bmetk/IoTDataCollection/cad/misc/mlx90614-module-2.snapshot.2/MLX90164_Option_Code_Zoom_Optimized.jpg

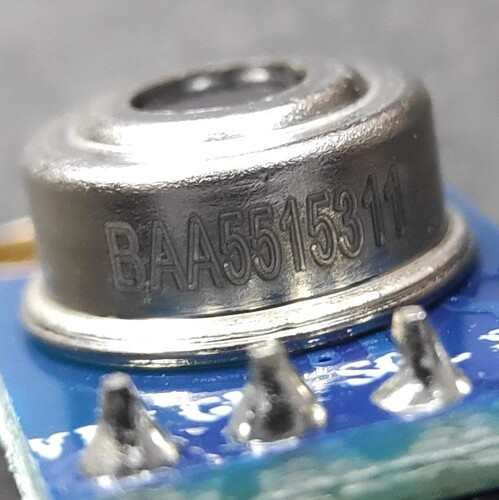
cad/misc/mlx90614-module-2.snapshot.2/MLX90164_Option_Code_Zoom_Optimized.jpg
