bmetk/IoTDataCollection/README.md

# IoTDataCollection
Thesis project: Design and development of an IoT based data collection / data analysis system
