bmetk/IoTDataCollection/cad/misc/mlx90614-module-2.snapshot.2/MLX90614XAA_Module.jpg

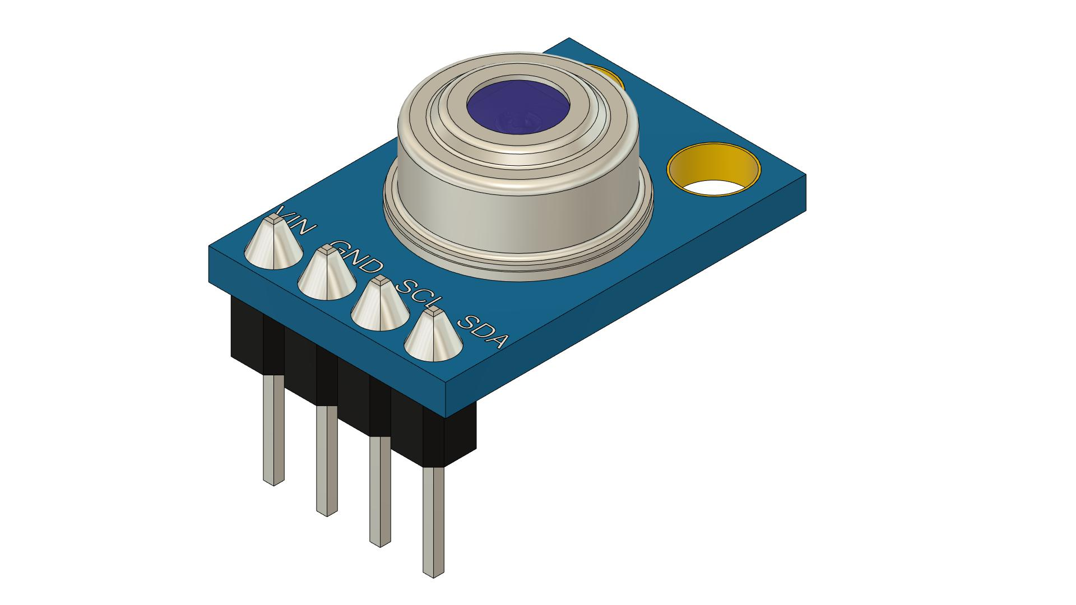
cad/misc/mlx90614-module-2.snapshot.2/MLX90614XAA_Module.jpg
