bmetk/IoTDataCollection/cad/misc/mlx90614-module-2.snapshot.2/MLX90614XAA_Module_Angle_View_Bottom.jpg

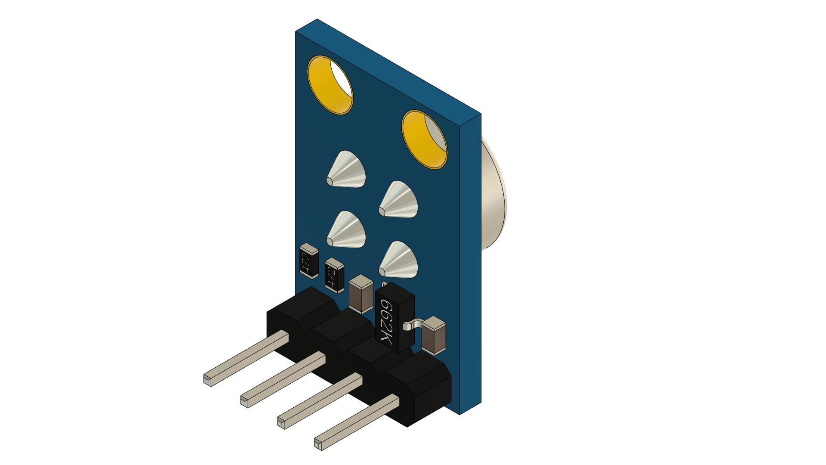
cad/misc/mlx90614-module-2.snapshot.2/MLX90614XAA_Module_Angle_View_Bottom.jpg
