bmetk/IoTDataCollection/cad/misc/mpu-9250-9dof-imu-1.snapshot.4/IMG_8919.JPG

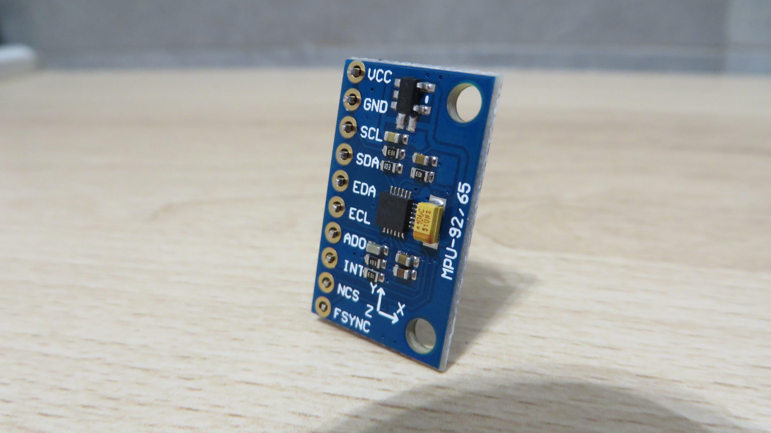
cad/misc/mpu-9250-9dof-imu-1.snapshot.4/IMG_8919.JPG
