bmetk/IoTDataCollection/cad/misc/mpu-9250-9dof-imu-1.snapshot.4/MPU-9250.png

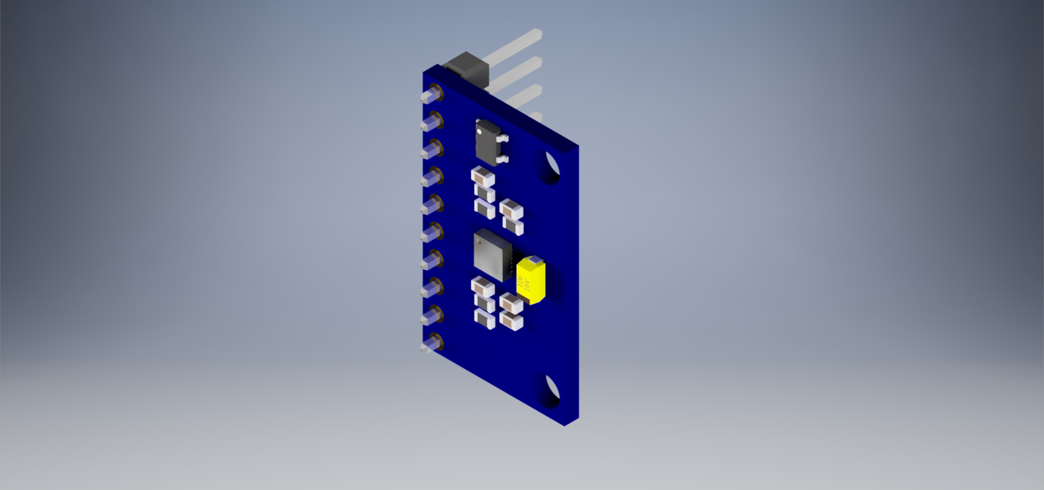
cad/misc/mpu-9250-9dof-imu-1.snapshot.4/MPU-9250.png
