bmetk/IoTDataCollection/cad/3D printing/CE3PRO_display_base.3mf

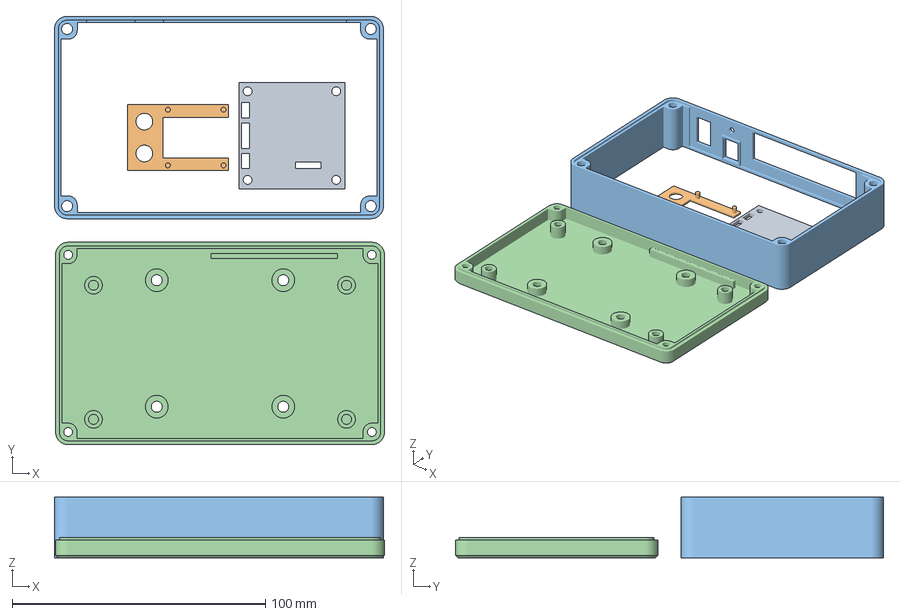
[picture p12: CAD file, 2023-10-11]
cad/3D printing/CE3PRO_display_base.3mf
130.4 x 169.3 x 24.0 mm
display_base.stl
dust_cover.stl
housing_side.stl
housing_bottom.stl
