bmetk/IoTDataCollection/cad/current sensor/current_sensor_base.stl

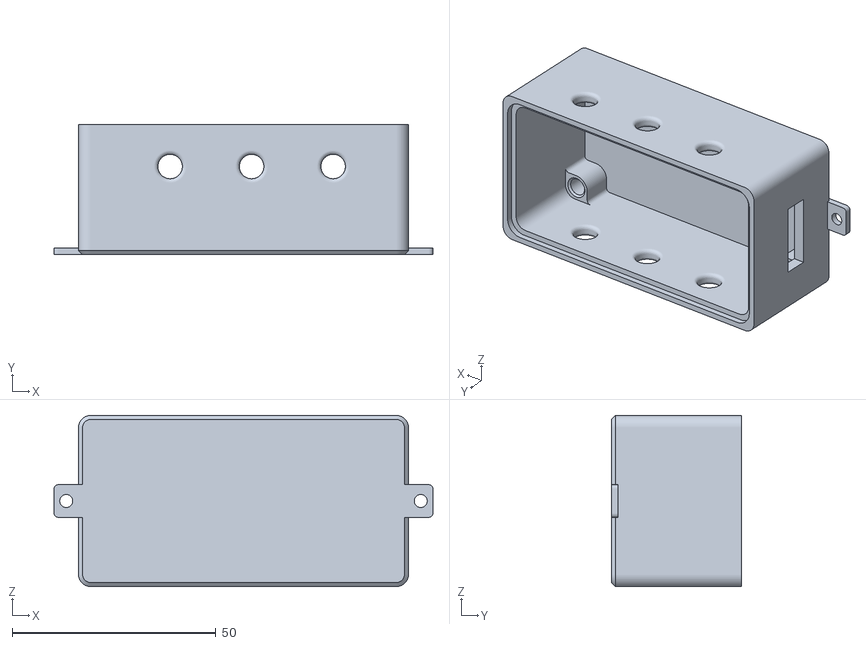
[picture p13: CAD file, 2023-11-07]
cad/current sensor/current_sensor_base.stl
93.0 x 32.0 x 42.0
