bmetk/IoTDataCollection/cad/EN3-01/disk_6_slot_wide.stl

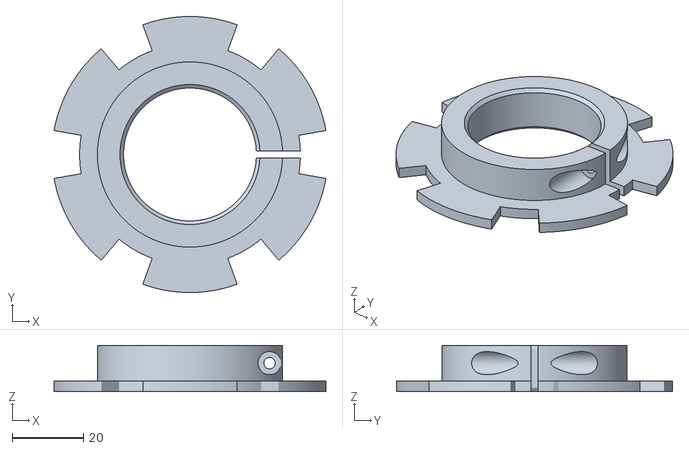
[picture p14: CAD file, 2024-02-10]
cad/EN3-01/disk_6_slot_wide.stl
76.3 x 77.5 x 13.0
