bmetk/IoTDataCollection/cad/housing/front_panel.stl

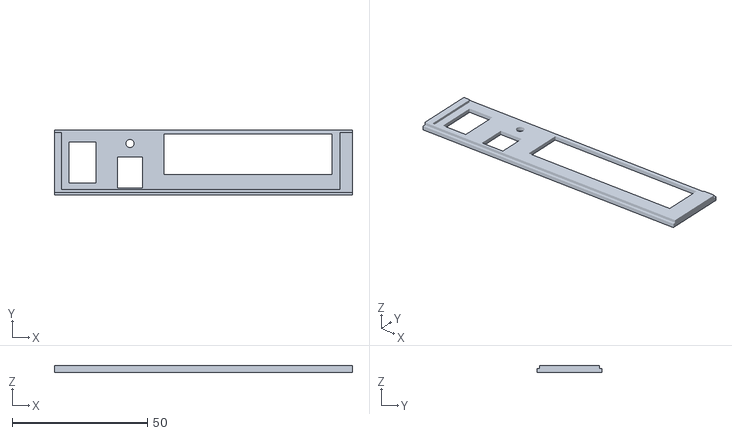
[picture p15: CAD file, 2023-10-11]
cad/housing/front_panel.stl
110.0 x 24.0 x 2.50
