bmetk/IoTDataCollection/cad/housing/v_2/housing_top_v_2_2.stl

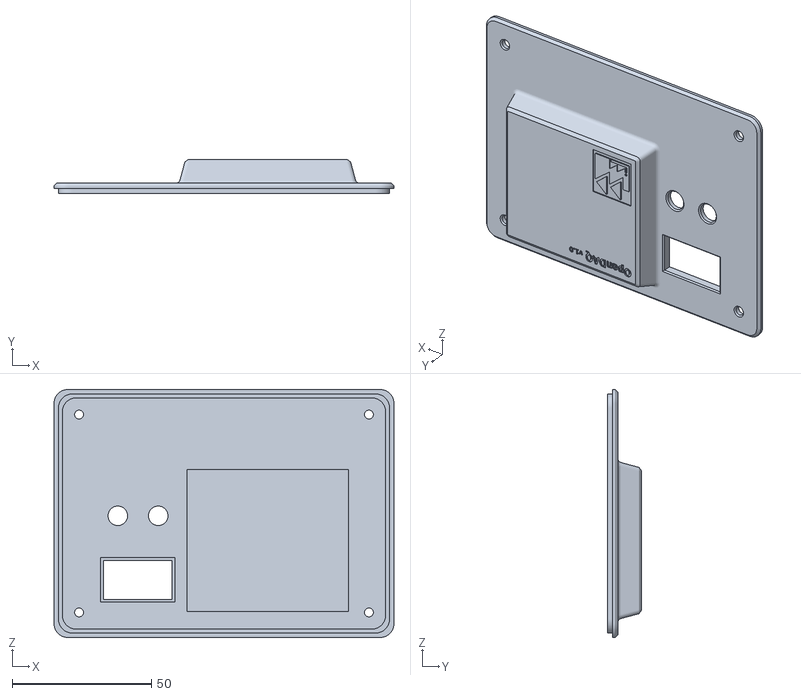
[picture p16: CAD file, 2023-11-07]
cad/housing/v_2/housing_top_v_2_2.stl
122.0 x 12.3 x 89.0
