bmetk/IoTDataCollection/cad/misc/mlx_mount_2mm.stl

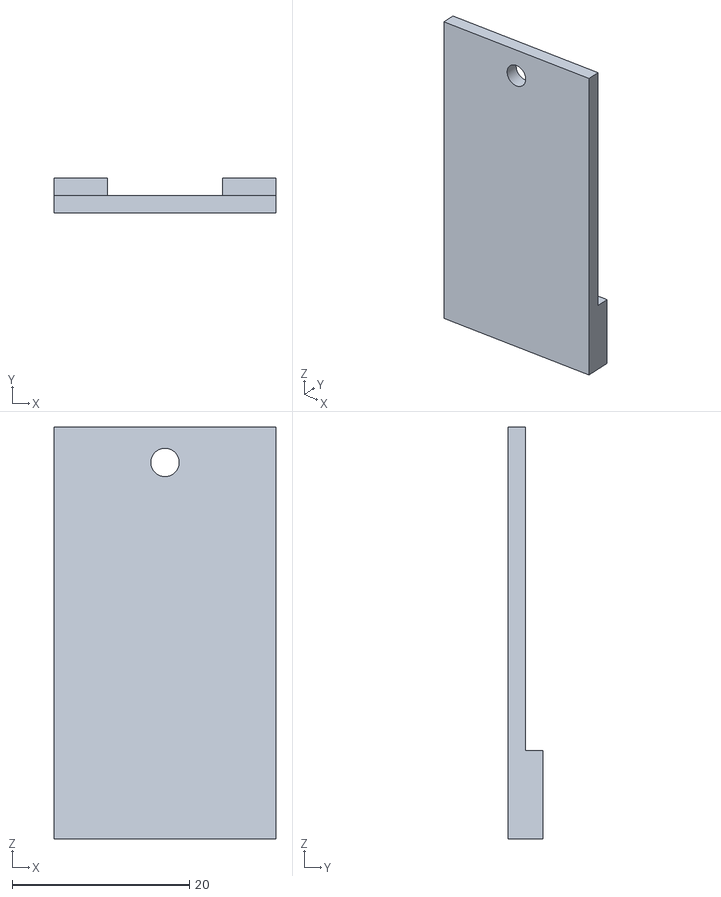
[picture p17: CAD file, 2023-11-07]
cad/misc/mlx_mount_2mm.stl
25.0 x 4.00 x 46.5
