bmetk/IoTDataCollection/cad/misc/mpu-9250-9dof-imu-1.snapshot.4/MPU-9250.stp

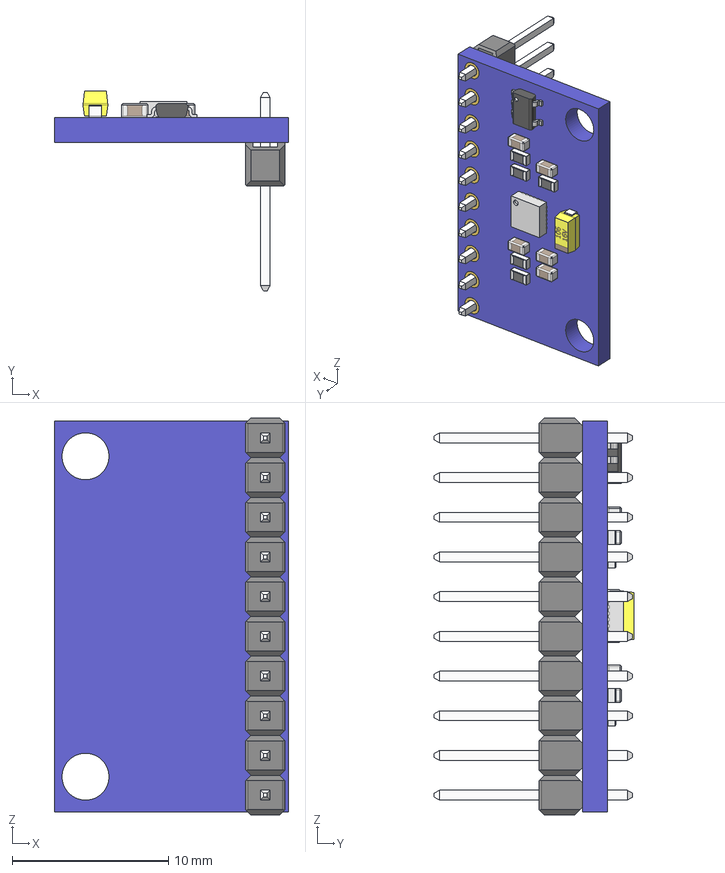
[picture p18: CAD file, 2023-11-07]
cad/misc/mpu-9250-9dof-imu-1.snapshot.4/MPU-9250.stp
15.0 x 12.8 x 25.4 mm
board
hole_plating x 20
Pin Header 1x10 TH Pitch 2.54mm
MPU-9250_1
tantalum 10uF
SOT23_5
RESC-0603 x 5
CAPC-0603-T0.9-BN x 5
