bmetk/IoTDataCollection/pcb/resources/ZMCT103C/zmct103c.stp

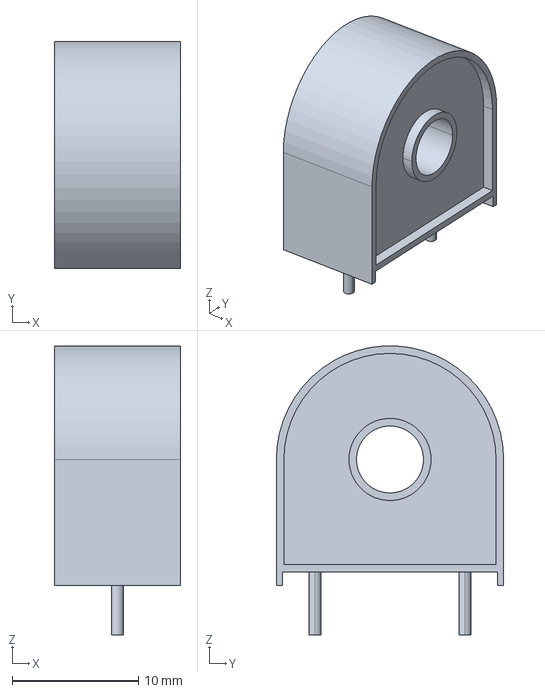
[picture p19: CAD file, 2023-11-07]
pcb/resources/ZMCT103C/zmct103c.stp
10.0 x 18.0 x 22.9 mm
