bmetk/IoTDataCollection/pcb/zmct_3phase/zmct_3phase/zmct_3phase.step

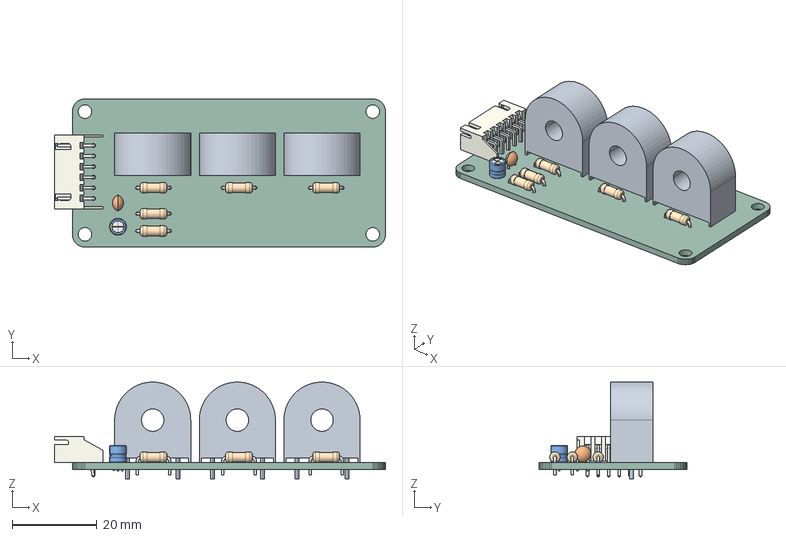
[picture p20: CAD file, 2023-11-07]
pcb/zmct_3phase/zmct_3phase/zmct_3phase.step
78.2 x 35.0 x 22.9 mm
zmct_3phase PCB
