bmetk/IoTDataCollection/cad/3D printing/dust_cover.stl

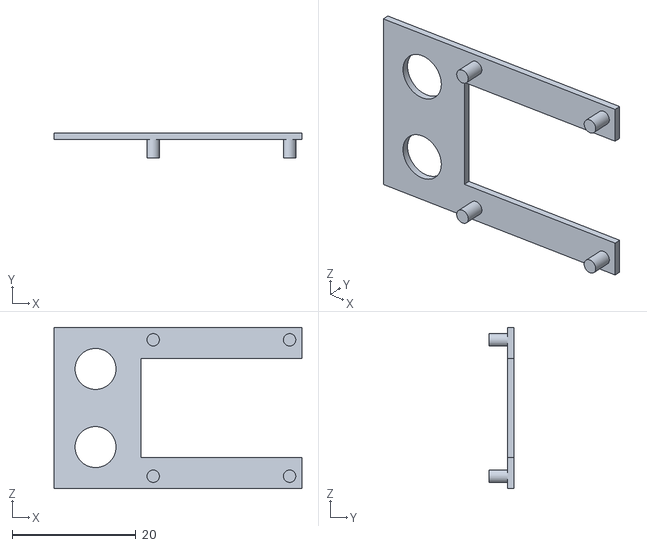
[picture p21: CAD file, 2023-10-11]
cad/3D printing/dust_cover.stl
40.0 x 4.00 x 26.0
