bmetk/IoTDataCollection/cad/current sensor/current_sensor_cover.stl

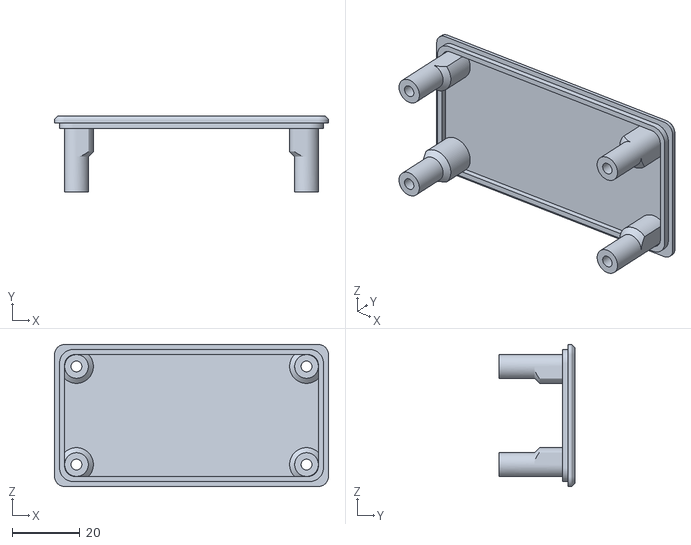
[picture p22: CAD file, 2023-11-07]
cad/current sensor/current_sensor_cover.stl
81.0 x 22.4 x 42.0
