bmetk/IoTDataCollection/cad/EN3-01/sensor_adapter.stl

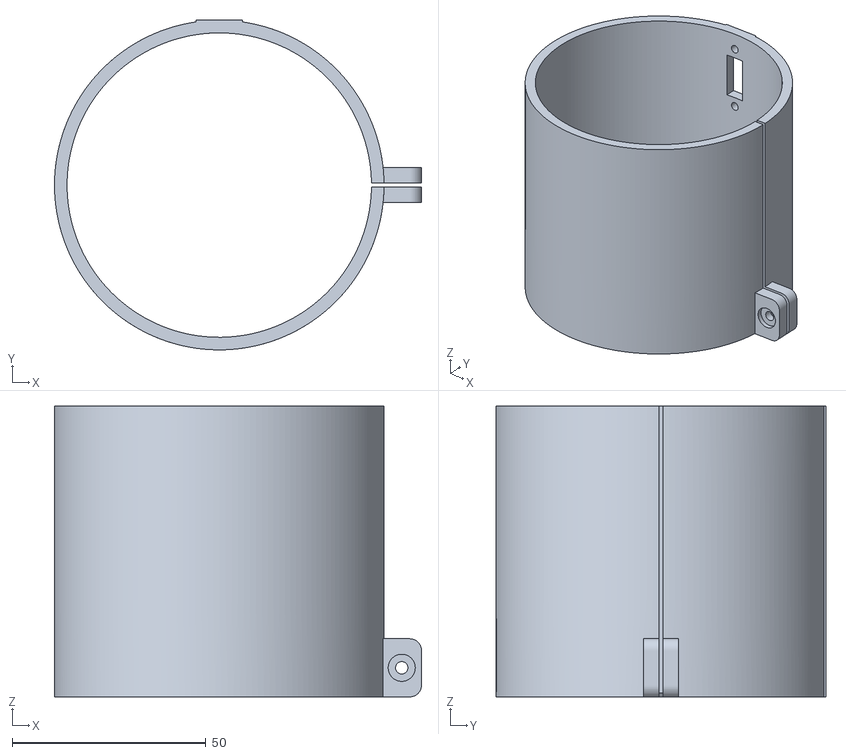
[picture p23: CAD file, 2023-11-07]
cad/EN3-01/sensor_adapter.stl
94.7 x 85.0 x 75.0
