bmetk/IoTDataCollection/cad/housing/v_2/housing_base_v_2_sw.stl

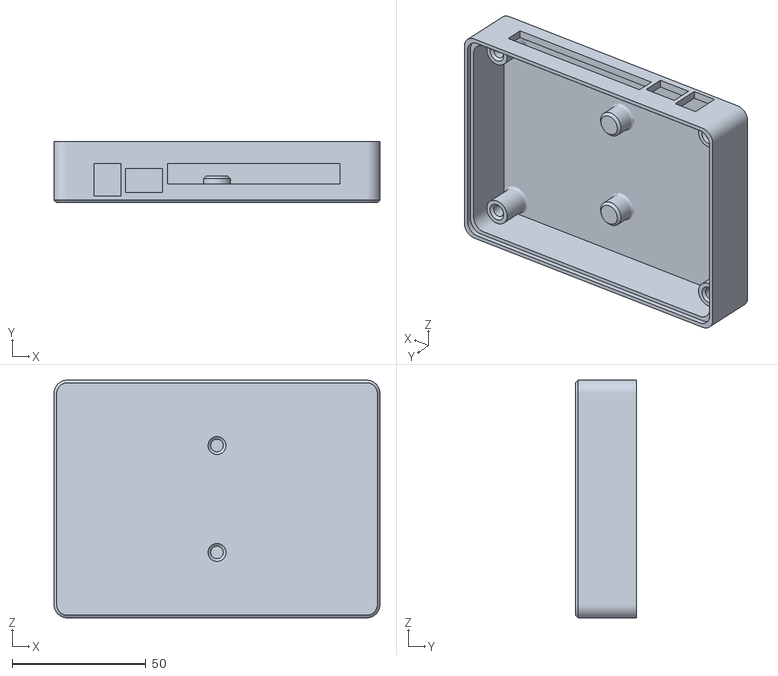
[picture p24: CAD file, 2023-10-11]
cad/housing/v_2/housing_base_v_2_sw.stl
122.0 x 23.0 x 89.0
