bmetk/IoTDataCollection/cad/misc/mlx_mount_4mm.stl

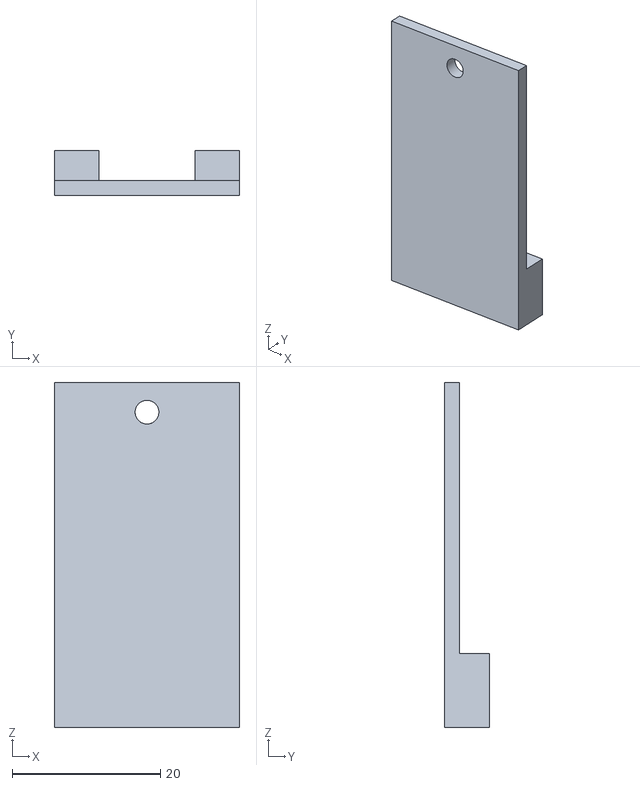
[picture p25: CAD file, 2023-11-07]
cad/misc/mlx_mount_4mm.stl
25.0 x 6.00 x 46.5
