bmetk/IoTDataCollection/cad/3D printing/display_base.stl

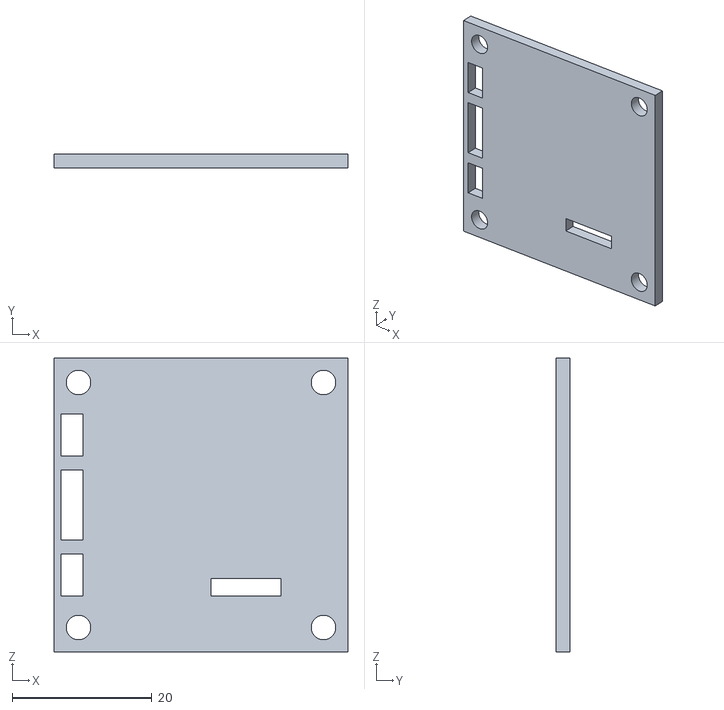
[picture p26: CAD file, 2023-10-11]
cad/3D printing/display_base.stl
42.0 x 2.00 x 42.0
