bmetk/IoTDataCollection/cad/EN3-01/disk_6_slot.stl

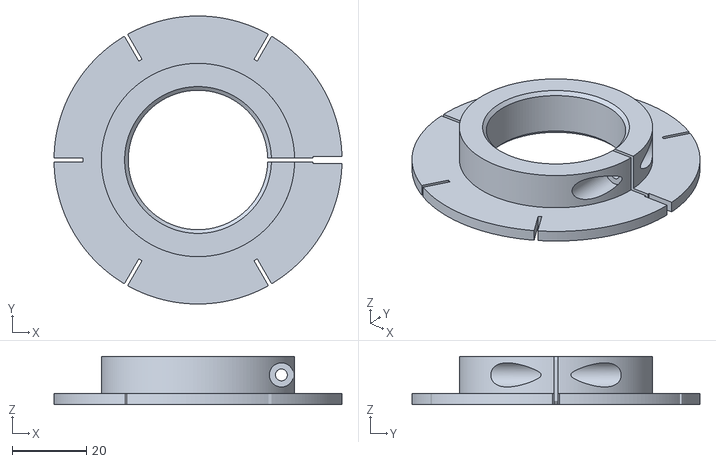
[picture p27: CAD file, 2023-11-07]
cad/EN3-01/disk_6_slot.stl
77.5 x 77.5 x 13.0
