bmetk/IoTDataCollection/cad/misc/panel_holder.stl

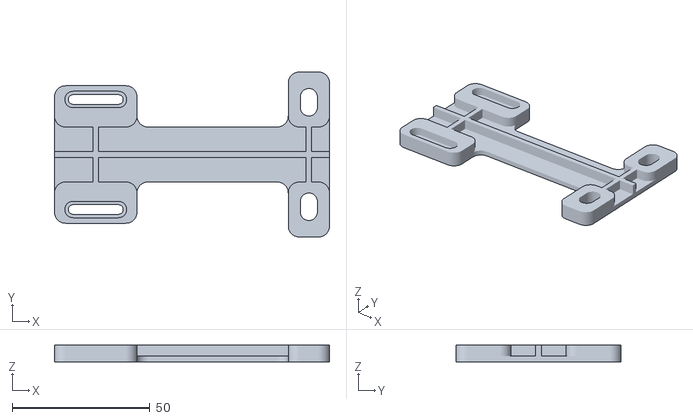
[picture p28: CAD file, 2023-11-07]
cad/misc/panel_holder.stl
100.0 x 60.0 x 6.00
