bmetk/IoTDataCollection/cad/3D printing/housing_bottom.stl

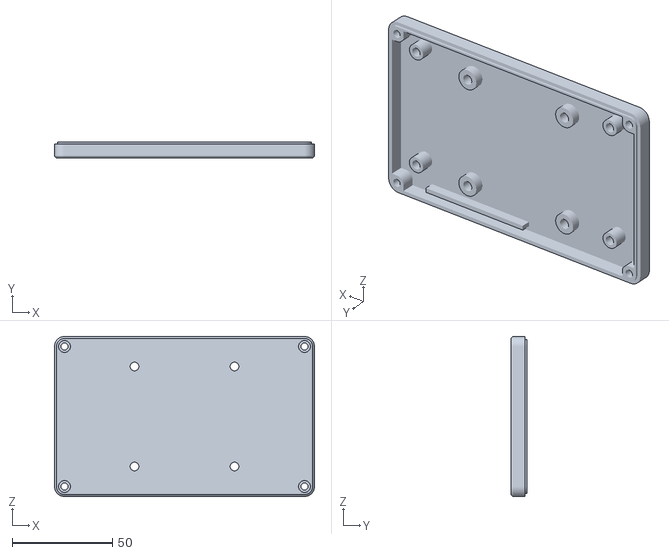
[picture p29: CAD file, 2023-10-11]
cad/3D printing/housing_bottom.stl
130.0 x 8.00 x 80.0
