bmetk/IoTDataCollection/cad/misc/mlx_mount_3mm.stl

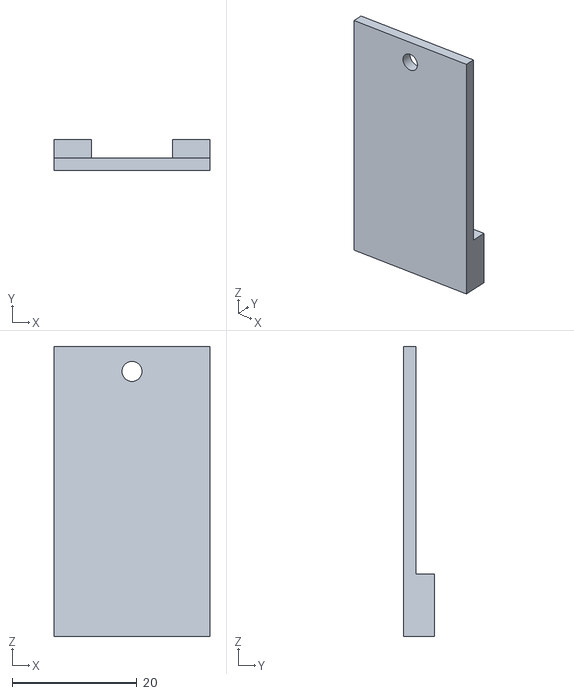
[picture p30: CAD file, 2023-11-07]
cad/misc/mlx_mount_3mm.stl
25.0 x 5.00 x 46.5
