bmetk/IoTDataCollection/cad/3D printing/housing_side.stl

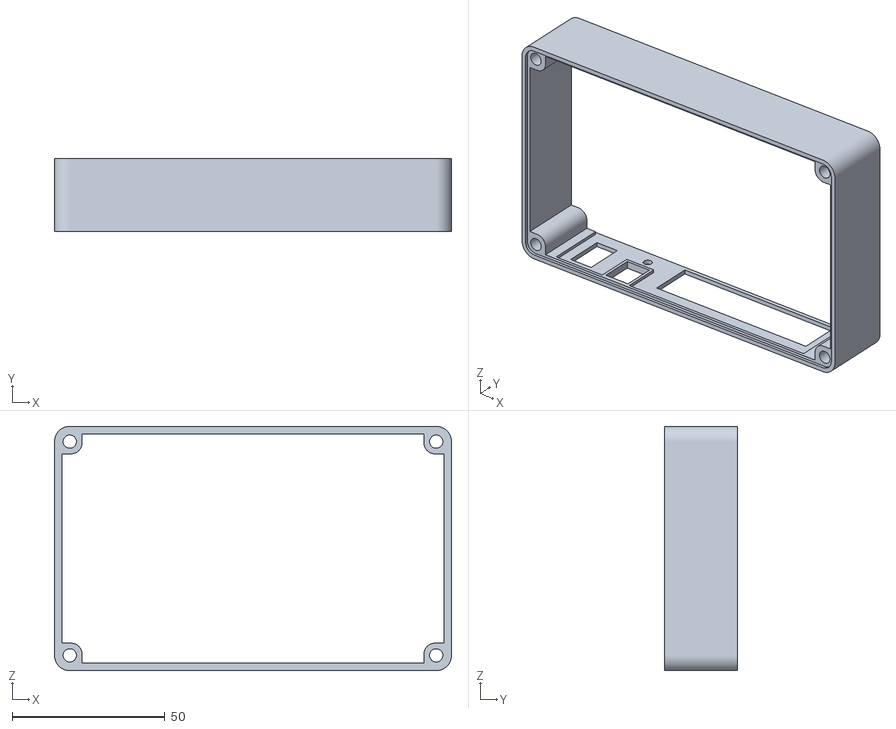
[picture p31: CAD file, 2023-10-11]
cad/3D printing/housing_side.stl
130.0 x 24.0 x 80.0
