bmetk/IoTDataCollection/cad/misc/mlx_holder.stl

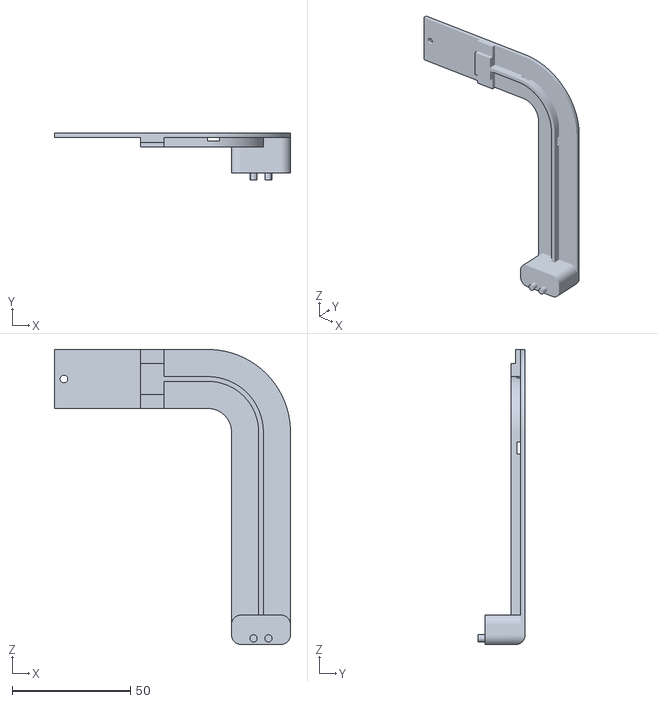
[picture p32: CAD file, 2023-11-07]
cad/misc/mlx_holder.stl
100.0 x 20.0 x 125.0
