bmetk/IoTDataCollection/cad/misc/spacer_7.5mm.stl

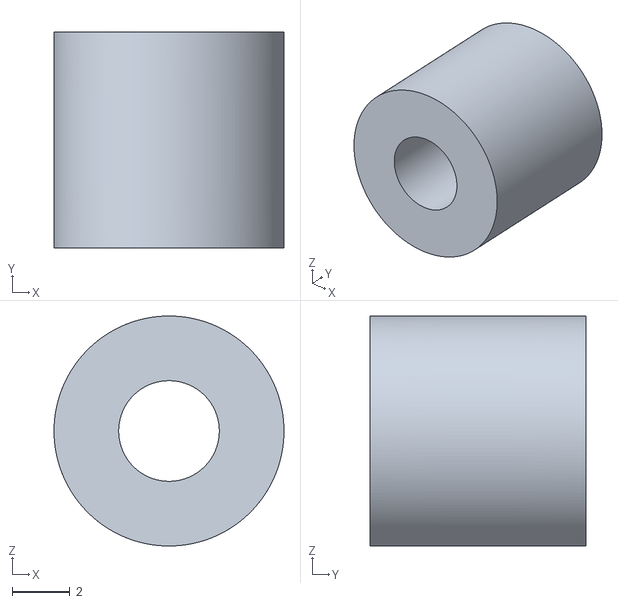
[picture p33: CAD file, 2023-10-11]
cad/misc/spacer_7.5mm.stl
8.00 x 7.50 x 8.00
