bmetk/IoTDataCollection/(list of files, cad)

Other CAD files:
pcb/resources/ZMCT103C/zmct1037.stl
cad/housing/v_2/housing_base_v_2.stl
cad/EN3-01/disk_12_slot.stl
cad/EN3-01/Assembly2.iam
cad/EN3-01/OldVersions/Assembly2.0014.iam
cad/EN3-01/OldVersions/disk_12_slot.0005.ipt
cad/EN3-01/OldVersions/disk_6_slot.0002.ipt
cad/EN3-01/OldVersions/lathe_spindle_end.0003.ipt
cad/EN3-01/OldVersions/sensor_adapter.0011.ipt
cad/EN3-01/disk_12_slot.ipt
cad/EN3-01/disk_6_slot.ipt
cad/EN3-01/disk_6_slot_wide.ipt
cad/EN3-01/lathe_spindle_end.ipt
cad/EN3-01/sensor_adapter.ipt
cad/assembly/v_1/Assembly1.iam
cad/assembly/v_1/Assembly1_for_rendering.iam
cad/assembly/v_1/OldVersions/Assembly1.0022.iam
cad/assembly/v_2/OldVersions/assembly_v_2.0014.iam
cad/assembly/v_2/OldVersions/assembly_v_2_2.0005.iam
cad/assembly/v_2/assembly_v_2.iam
cad/assembly/v_2/assembly_v_2_2.iam
cad/current sensor/OldVersions/current_sensor.0008.iam
cad/current sensor/OldVersions/current_sensor_base.0012.ipt
cad/current sensor/OldVersions/current_sensor_cover.0008.ipt
cad/current sensor/current_sensor.iam
cad/current sensor/current_sensor_base.ipt
cad/current sensor/current_sensor_cover.ipt
cad/housing/v_1/OldVersions/dust_cover.0005.ipt
cad/housing/v_1/OldVersions/front_panel.0001.ipt
cad/housing/v_1/OldVersions/housing_base.0002.ipt
cad/housing/v_1/OldVersions/housing_bottom.0014.ipt
cad/housing/v_1/OldVersions/housing_side.0018.ipt
cad/housing/v_1/OldVersions/housing_top.0015.ipt
cad/housing/v_1/OldVersions/pcb_main_populated.0001.ipt
cad/housing/v_1/dust_cover.ipt
cad/housing/v_1/front_panel.ipt
cad/housing/v_1/housing_base.ipt
cad/housing/v_1/housing_bottom.ipt
cad/housing/v_1/housing_side.ipt
cad/housing/v_1/housing_top.ipt
cad/housing/v_2/OldVersions/housing_base_v_2.0012.ipt
cad/housing/v_2/OldVersions/housing_top_v_2.0008.ipt
cad/housing/v_2/OldVersions/housing_top_v_2_2.0011.ipt
cad/housing/v_2/housing_base_v_2.ipt
cad/housing/v_2/housing_top_v_2.ipt
cad/housing/v_2/housing_top_v_2.stl
cad/housing/v_2/housing_top_v_2_2.ipt
cad/misc/OldVersions/mlx_holder.0001.ipt
cad/misc/OldVersions/mlx_mount_2mm.0001.ipt
cad/misc/OldVersions/mlx_mount_3mm.0001.ipt
cad/misc/OldVersions/mlx_mount_4mm.0003.ipt
cad/misc/OldVersions/optocoupler.0002.ipt
cad/misc/OldVersions/panel_holder.0005.ipt
cad/misc/OldVersions/rocker_switch.0003.ipt
cad/misc/button_cap.ipt
cad/misc/mlx90614-module-2.snapshot.2/MLX90614XAA_Module.f3d
cad/misc/mlx90614-module-2.snapshot.2/MLX90614XAA_Module.step
cad/misc/mlx_holder.ipt
cad/misc/mlx_mount_2mm.ipt
cad/misc/mlx_mount_3mm.ipt
cad/misc/mlx_mount_4mm.ipt
cad/misc/mpu-9250-9dof-imu-1.snapshot.4/MPU-9250.iam
cad/misc/mpu-9250-9dof-imu-1.snapshot.4/MPU-9250_Shrinkwrap.ipt
cad/misc/mpu-9250-9dof-imu-1.snapshot.4/parts/CAPC-0603-T0.9-BN.ipt
cad/misc/mpu-9250-9dof-imu-1.snapshot.4/parts/Pin Header 1x10 TH Pitch 2.54mm.ipt
cad/misc/mpu-9250-9dof-imu-1.snapshot.4/parts/QFN-24 3x3 0.4mm.ipt
cad/misc/mpu-9250-9dof-imu-1.snapshot.4/parts/RESC-0603.ipt
cad/misc/mpu-9250-9dof-imu-1.snapshot.4/parts/SOT23_5.ipt
cad/misc/mpu-9250-9dof-imu-1.snapshot.4/parts/board.ipt
cad/misc/mpu-9250-9dof-imu-1.snapshot.4/parts/hole_plating.ipt
cad/misc/mpu-9250-9dof-imu-1.snapshot.4/parts/tantalum 10uF.ipt
cad/misc/optocoupler.ipt
cad/misc/panel_holder.ipt
cad/misc/rocker_switch.ipt
cad/misc/screws/din912/din_912-m3x0_5-10-8_8.ipt
cad/misc/screws/din912/din_912-m3x0_5-10-8_8.stp
cad/misc/spacer_7.5mm.ipt
cad/pcb/OldVersions/display_base.0001.ipt
cad/pcb/OldVersions/display_buttons.0009.ipt
cad/pcb/OldVersions/pcb_main_populated.0008.ipt
cad/pcb/OldVersions/ssd1360.0001.ipt
cad/pcb/display_base.ipt
cad/pcb/display_buttons.ipt
cad/pcb/pcb_main_populated.ipt
cad/pcb/ssd1306.ipt
pcb/opendaq_carrier_1.0/BarrelJack_Wuerth_694108301002 (rev1).iam
pcb/opendaq_carrier_1.0/COMPOUND_1.ipt
pcb/opendaq_carrier_1.0/COMPOUND_2.ipt
pcb/opendaq_carrier_1.0/COMPOUND_3.ipt
pcb/opendaq_carrier_1.0/ESP32Wroom.iam
pcb/opendaq_carrier_1.0/JST_XH_B2B-XH-A_1x02_P2.50mm_Vertical.iam
pcb/opendaq_carrier_1.0/JST_XH_S3B-XH-A_1x03_P2.50mm_Horizontal.iam
pcb/opendaq_carrier_1.0/JST_XH_S4B-XH-A_1x04_P2.50mm_Horizontal.iam
pcb/opendaq_carrier_1.0/JST_XH_S5B-XH-A_1x05_P2.50mm_Horizontal.iam
pcb/opendaq_carrier_1.0/JST_XH_S6B-XH-A_1x06_P2.50mm_Horizontal.iam
pcb/opendaq_carrier_1.0/SOLID.ipt
pcb/opendaq_carrier_1.0/SOLID_1.ipt
pcb/opendaq_carrier_1.0/SOLID_2.ipt
pcb/opendaq_carrier_1.0/SOLID_3.ipt
pcb/opendaq_carrier_1.0/SOLID_4.ipt
pcb/opendaq_carrier_1.0/SOLID_5.ipt
pcb/opendaq_carrier_1.0/SSD1306_OLED_Display(128x64).iam
pcb/opendaq_carrier_1.0/Tactal Switch - THRU(12mmx12mmx8mm)-Black.iam
pcb/opendaq_carrier_1.0/kicad_module_3D_MINI560.iam
pcb/opendaq_carrier_1.0/opendaq_carrier_1.0 PCB.ipt
pcb/opendaq_carrier_1.0/opendaq_carrier_1.0.iam
pcb/resources/ZMCT103C/zmct103c.ipt
pcb/zmct_3phase/zmct_3phase/CP_Radial_D4.0mm_P2.00mm.iam
pcb/zmct_3phase/zmct_3phase/C_Disc_D3.8mm_W2.6mm_P2.50mm.iam
pcb/zmct_3phase/zmct_3phase/JST_XH_S6B-XH-A_1x06_P2.50mm_Horizontal.iam
pcb/zmct_3phase/zmct_3phase/R_Axial_DIN0207_L6.3mm_D2.5mm_P7.62mm_Horizontal.iam
pcb/zmct_3phase/zmct_3phase/SOLID.ipt
pcb/zmct_3phase/zmct_3phase/SOLID_1.ipt
pcb/zmct_3phase/zmct_3phase/SOLID_2.ipt
pcb/zmct_3phase/zmct_3phase/SOLID_3.ipt
pcb/zmct_3phase/zmct_3phase/SOLID_4.ipt
pcb/zmct_3phase/zmct_3phase/zmct103c.iam
pcb/zmct_3phase/zmct_3phase/zmct_3phase PCB.ipt
pcb/zmct_3phase/zmct_3phase/zmct_3phase.iam
