bmetk/IoTDataCollection/pcb/opendaq_carrier_1.0/opendaq_carrier_1.0.kicad_pcb

## KiCad design pcb/opendaq_carrier_1.0/opendaq_carrier_1.0.kicad_pcb (2023-10-11)

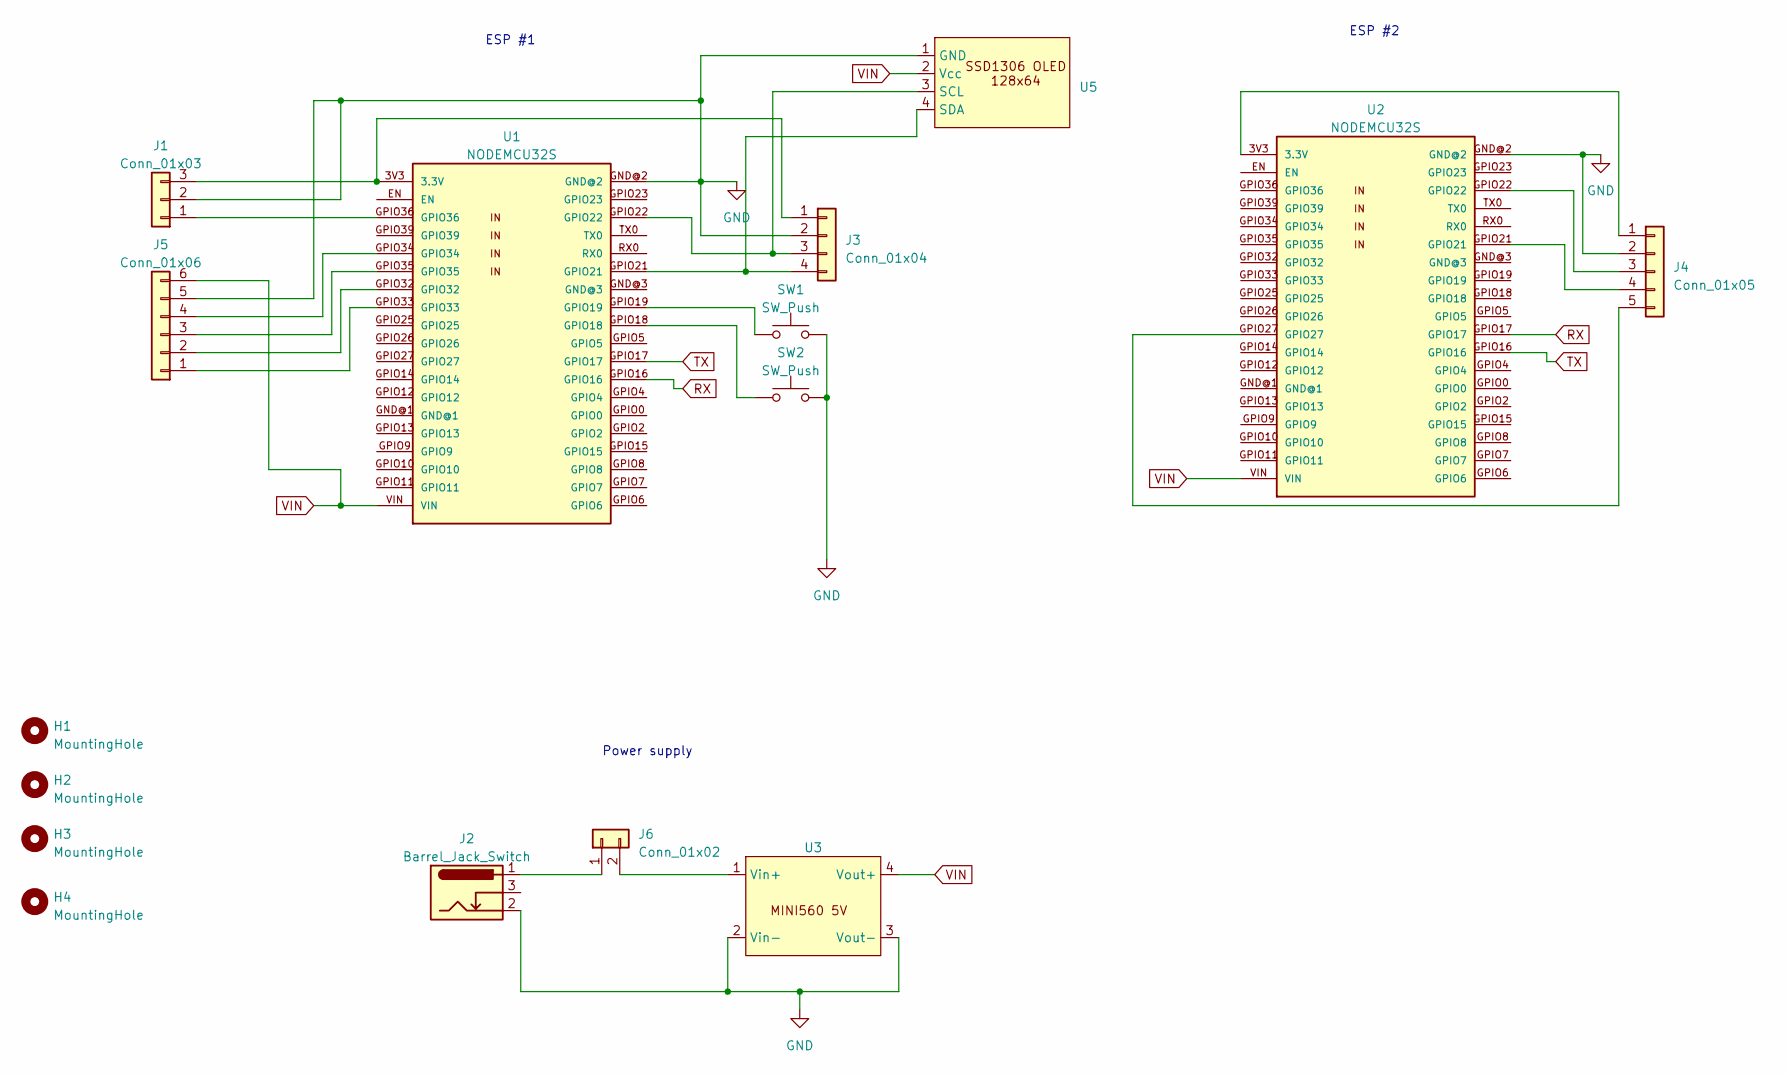
[picture p36: schematic opendaq_carrier_1.0.kicad_sch]

Parts:
H1, H2, H3, H4: MountingHole; MountingHole_3.2mm_M3_DIN965_Pad
J1: Conn_01x03; JST_XH_S3B-XH-A_1x03_P2.50mm_Horizontal
J2: Barrel_Jack_Switch; BarrelJack_Wuerth_6941xx301002
J3: Conn_01x04; JST_XH_S4B-XH-A_1x04_P2.50mm_Horizontal
J4: Conn_01x05; JST_XH_S5B-XH-A_1x05_P2.50mm_Horizontal
J5: Conn_01x06; JST_XH_S6B-XH-A_1x06_P2.50mm_Horizontal
J6: Conn_01x02; JST_XH_B2B-XH-A_1x02_P2.50mm_Vertical
SW1, SW2: SW_Push; SW_PUSH-12mm
U1, U2: NODEMCU32S
U3: MINI_560_buck
U5: SSD1306_OLED_128x64

Connections:
GND: J1.2, J2.2, J3.2, J4.2, J5.5, SW1.2, SW2.2, U1.GND@2, U2.GND@2, U3.2 (Vin-), U3.3 (Vout-), U5.1 (GND)
unnamed: J1.1, U1.GPIO36
unnamed: J1.3, J3.1, U1.3V3 (3.3V)
unnamed: J3.3, U1.GPIO22, U5.3 (SCL)
unnamed: J3.4, U1.GPIO21, U5.4 (SDA)
unnamed: J4.1, U2.3V3 (3.3V)
unnamed: J4.3, U2.GPIO22
unnamed: J4.4, U2.GPIO21
unnamed: J4.5, U2.GPIO27
unnamed: J5.1, U1.GPIO33
unnamed: J5.2, U1.GPIO32
unnamed: J5.3, U1.GPIO35
unnamed: J5.4, U1.GPIO34
unnamed: J2.1, J6.1
unnamed: J6.2, U3.1 (Vin+)
unnamed: SW1.1, U1.GPIO19
unnamed: SW2.1, U1.GPIO18
RX: U1.GPIO16, U2.GPIO17
TX: U1.GPIO17, U2.GPIO16
VIN: J5.6, U1.VIN, U2.VIN, U3.4 (Vout+), U5.2 (Vcc)

Notes on the sheet:
Power supply
ESP #1
ESP #2

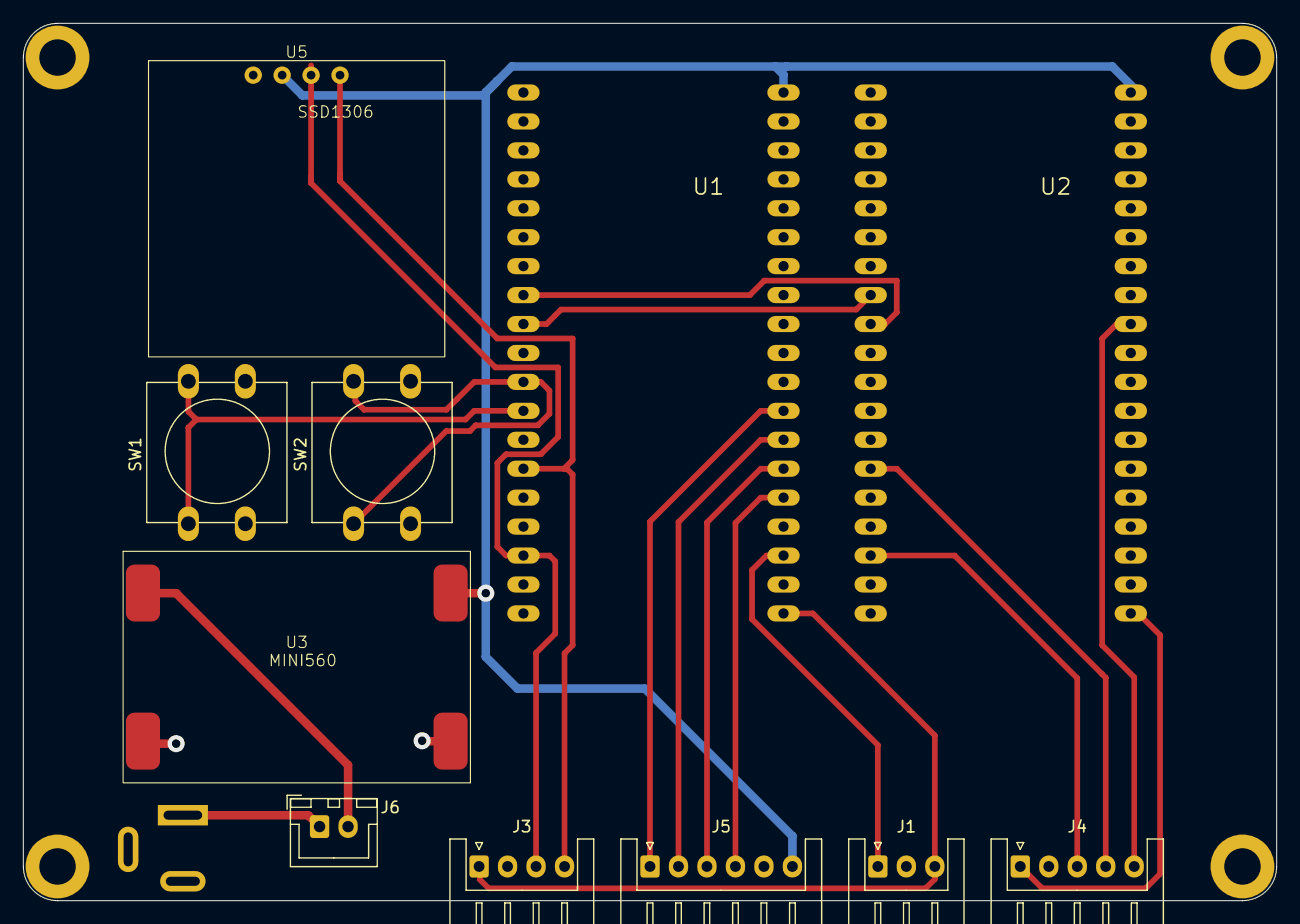
[picture p37: board opendaq_carrier_1.0.kicad_pcb from above]

Board: 2 copper layers, 110.0 x 77.0 mm, 16 parts (1 on the bottom side), 20 nets.
