bmetk/IoTDataCollection/twoesp/esp1/src/main.cpp

/*

  This version runs 3 sensors, a display and navigation buttons
  
  The sensors are:
    - optocouler
    - temperature sensor
    - current meter

  The current diplay is a 0.92" 128x64 oled display.

  The two navigation buttons are:
    - Next: going to the next possinle state
    - Select: entering a new state/calling a function

  To utilise the two cores, both are running a task:
    - Task 1: display, mqtt etc.
    - Task 2: data collection

*/



#include <Arduino.h>
#include <menu.h>
#include <measurement.h>
#include <connectivity.h>
#include <parameters.h>



////////////////////////////////////////////////////////////////////////////////////////
//
//    Constants / Definitions
//
////////////////////////////////////////////////////////////////////////////////////////



TaskHandle_t Task1;
TaskHandle_t Task2;

#define NEXT_PIN 18
#define ENTER_PIN 19
volatile bool nextPressed = false;
volatile bool enterPressed = false;
unsigned long buttonTime = 0;
unsigned long lastButtonTime = 0;
const int debounceInteval = 250;
unsigned long previousMillis;
const unsigned int measurementInterval = 1300;



////////////////////////////////////////////////////////////////////////////////////////
//
//    Function definitions
//
////////////////////////////////////////////////////////////////////////////////////////



//-----------------------
// Checking ESP1's health
//-----------------------
bool prevClientCon = false, prevTemp = false; 
bool clientCon = false, temp = false; 

void checkEsp1Health() {
  clientCon = checkClientCon();
  temp = checkTempSensor();

  if(clientCon){
    setErrorEnable(0, 0);
  }
  else {
    setErrorEnable(0, 1);
  }
  if(temp){
    setErrorEnable(3, 0);
  }
  else {
    setErrorEnable(3, 1);

  }
  if (prevClientCon != clientCon || prevTemp != temp){
    prevClientCon = clientCon;
    prevTemp = temp;

    firstLevel();
  }
}

//------------------------
// Handling button presses
//------------------------
void IRAM_ATTR nextOnPress() {
  buttonTime = millis();
  if(buttonTime - lastButtonTime > debounceInteval){
    nextPressed = true;
    lastButtonTime = buttonTime;
  }
}

void IRAM_ATTR enterOnPress() {
  buttonTime = millis();
  if(buttonTime - lastButtonTime > debounceInteval){
    enterPressed = true;
    lastButtonTime = buttonTime;
  }
}


//----------------------------------------------
// Function for Task1 - handling the menu system
//----------------------------------------------
void Task1code(void * pvParameters){
  for(;;){
    // checking main ESP's health
    checkEsp1Health();

    if(nextPressed) {
      updateState("next");
      nextPressed = false;
    }
    else if(enterPressed) {
      updateState("enter");
      enterPressed = false;
    }
    

    
    vTaskDelay(12);
  }
}


//------------------------------------------------------------
// Function for Task2 - reading sensor data and sending it out
//------------------------------------------------------------
void Task2code(void * pvParameters){
  while(!checkClientCon()){
    delay(200);
    
    clientLoop();
  }
  previousMillis = millis();
  clearSerialInterconn();
  sendSerialMessage(0x01);
  setRPMTime();
  
  for(;;){
    clientLoop();
    processSerial(checkSerialMessage());

    if(checkSendMeasurements()) { // check if acceleration data is ready
      resetSendMeasurements(); // reseting the flag
      sendCurrent();
      getRpm();
      getTempC();
      //sendSerialMessage(0x01);

    }
    // check if acceleration data is ready
    if(millis() - previousMillis > measurementInterval && isCollectionEnabled() && checkEsp2State() == "OFF") { 
      sendCurrent();
      getRpm();
      getTempC();

      previousMillis = millis();
    }
    
    clientLoop();
    vTaskDelay(10);
  }
}



////////////////////////////////////////////////////////////////////////////////////////
//
//    Setup
//
////////////////////////////////////////////////////////////////////////////////////////



void setup() {
  setCpuFrequencyMhz(240);

  Serial.begin(115200);

  pinMode(NEXT_PIN, INPUT_PULLUP);
  pinMode(ENTER_PIN, INPUT_PULLUP);
  pinMode(DRDY_PIN, INPUT_PULLDOWN);

  attachInterrupt(NEXT_PIN, nextOnPress, FALLING);
  attachInterrupt(ENTER_PIN, enterOnPress, FALLING);

  // starting up the sensors and the wireless connection
  initCom();
  setupSensors();  
  
  // setting up the display
  setupDisplay();
  firstLevel();


  xTaskCreatePinnedToCore(
                    Task1code,   /* Task function. */
                    "Task1",     /* name of task. */
                    10000,       /* Stack size of task */
                    NULL,        /* parameter of the task */
                    1,           /* priority of the task */
                    &Task1,      /* Task handle to keep track of created task */
                    0);          /* pin task to core 0 */                  
  delay(500); 

  //create a task that will be executed in the Task2code() function, with priority 1 and executed on core 1
  xTaskCreatePinnedToCore(
                    Task2code,   /* Task function. */
                    "Task2",     /* name of task. */
                    15000,       /* Stack size of task */
                    NULL,        /* parameter of the task */
                    1,           /* priority of the task */
                    &Task2,      /* Task handle to keep track of created task */
                    1);          /* pin task to core 1 */
  delay(500);
}

void loop() {
  // put your main code here, to run repeatedly:
}
