bmetk/IoTDataCollection/twoesp/esp1/include/credentials.h

/*const char* SSID      =    "GEPULETWIFI";
const char* PWD       =    "GepuletWifi987*";
const char* MQTT_USR  =    "bmetk";
const char* MQTT_PWD  =    "iot23";
const char* MQTT_ADR  =    "test.mosquitto.org"; //"152.66.34.82"
const short PORT      =    1883; //32701

const char* CLIENT_ID = "opendaq1";
*/


const char* SSID      =    "GEPULETWIFI";
const char* PWD       =    "GepuletWifi987*";
const char* MQTT_USR  =    "bmetk";
const char* MQTT_PWD  =    "iot23";
const char* MQTT_ADR  =    "152.66.34.82"; //"152.66.34.82"
const short PORT      =    32701;

const char* CLIENT_ID = "opendaq1";
