bmetk/IoTDataCollection/twoesp/esp1/include/measurement.h

#ifndef MEASUREMENT_H
#define MEASUREMENT_H


    void setupSensors();
    void getCurrent();
    void sendCurrent();
    void setRPMTime();
    void getRpm();
    void getTempC();
    bool checkTempSensor();




#endif
