bmetk/IoTDataCollection/(commit log)

2023-10-11 major updates
    added:
    - dash frontend
    - analytics backend (w/websocket)
    - cad files
    - pcb design
    - preprocessing notebook
    [Assembly1.0022.iam, Assembly1.iam, Assembly1_for_rendering.iam, BarrelJack_Wuerth_694108301002 (rev1).iam, CE3PRO_display_base.3mf, COMPOUND_1.ipt, COMPOUND_2.ipt, COMPOUND_3.ipt]
2023-11-07 minor updates, cleanups, new pcb design
    [Assembly2.0014.iam, Assembly2.iam, CAPC-0603-T0.9-BN.ipt, CE3PRO_display_base.3mf, CP_Radial_D4.0mm_P2.00mm.iam, C_Disc_D3.8mm_W2.6mm_P2.50mm.iam, JST_XH_S6B-XH-A_1x06_P2.50mm_Horizontal.iam, MLX90614XAA_Module.f3d]
2024-01-05 Final updates for 2023
    [CE3PRO_display_base.3mf, display_base.0001.ipt, display_base.ipt, display_base.stl, display_buttons.0009.ipt, display_buttons.ipt, dust_cover.stl, housing_bottom.stl]
2024-02-10 finalizing update
    [disk_6_slot_wide.ipt, disk_6_slot_wide.stl]
2024-02-15 added bom list and tips
